CoolNamesAllTaken/vibamix/affinity/vibamix_placard/exports/vibamix_placard.pdf

# Vibamix

### A device for playing "will it blend" with people and personalities!

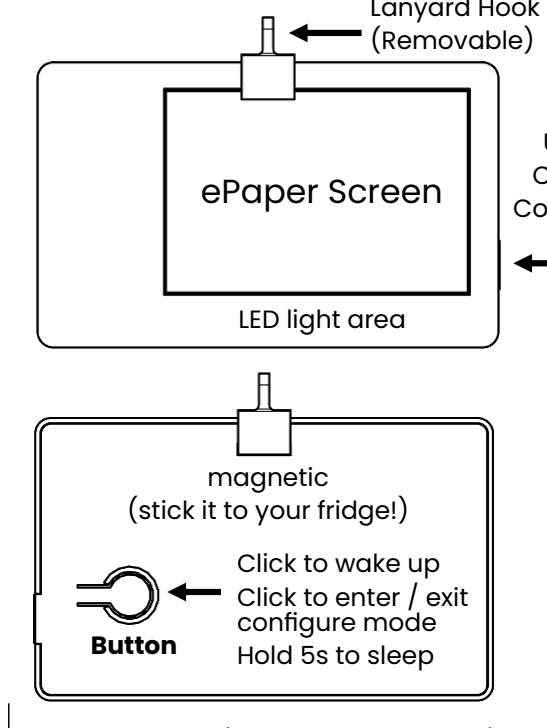
[picture p1: figure]
ePaper Screen; (Removable); LED light area; magnetic (stick it to your fridge!); Click to wake up Click to enter / exit configure mode Hold 5s to sleep Button

USB C
Charge

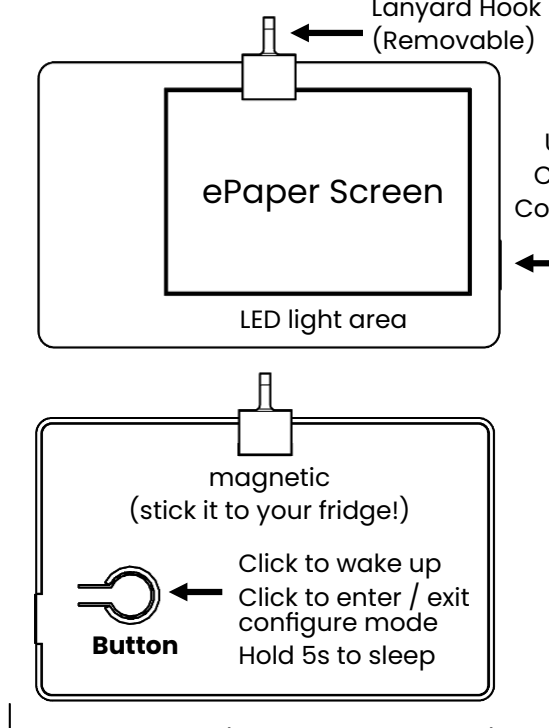
[picture p2: figure]
ePaper Screen; (Removable); LED light area; magnetic (stick it to your fridge!); Click to wake up Click to enter / exit configure mode Hold 5s to sleep Button

Connector

Lanyard Hook

github.com/CoolNamesAllTaken/vibamix

# Vibamix

### A device for playing "will it blend" with people and personalities!

USB C
Charge

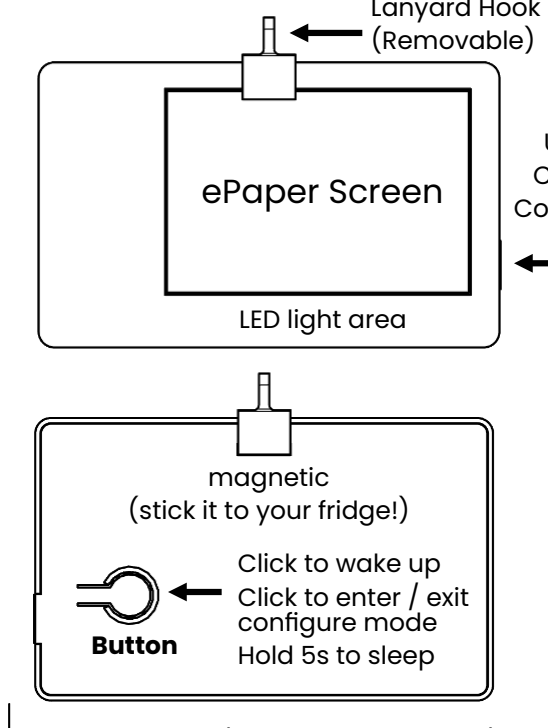
[picture p3: figure]
ePaper Screen; (Removable); LED light area; magnetic (stick it to your fridge!); Click to wake up Click to enter / exit configure mode Hold 5s to sleep Button

Connector

Lanyard Hook

github.com/CoolNamesAllTaken/vibamix

# Vibamix

### A device for playing "will it blend" with people and personalities!

USB C
Charge
Connector

Lanyard Hook

github.com/CoolNamesAllTaken/vibamix

# Vibamix

### A device for playing "will it blend" with people and personalities!

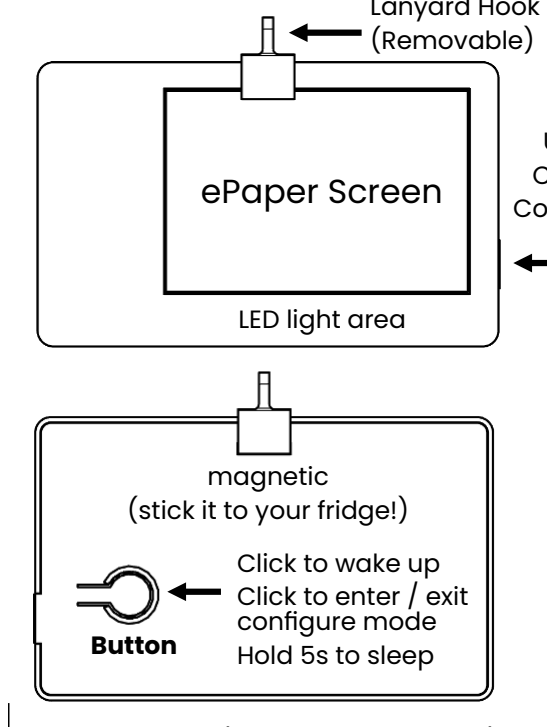
[picture p4: figure]
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

USB C
Charge

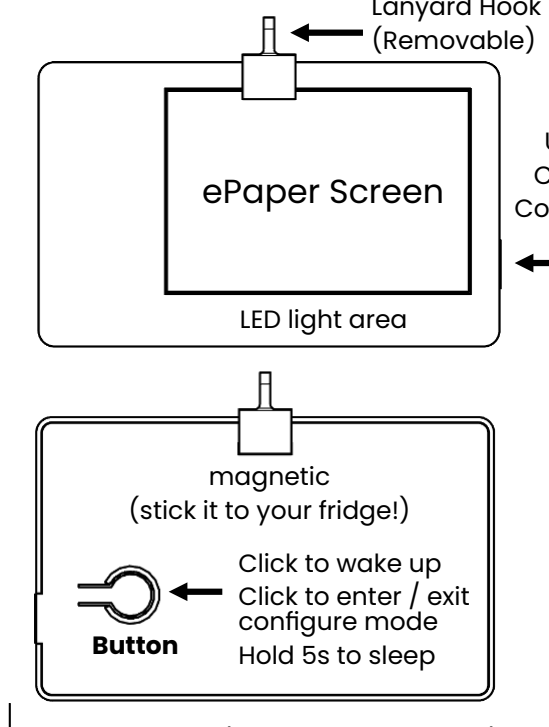
[picture p5: figure]
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

Connector

Lanyard Hook

github.com/CoolNamesAllTaken/vibamix

# Vibamix

### A device for playing "will it blend" with people and personalities!

USB C
Charge

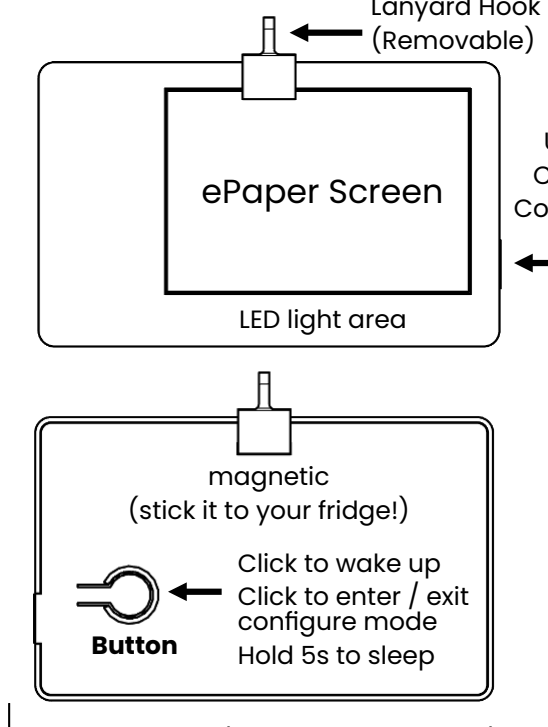
[picture p6: figure]
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

Connector

Lanyard Hook

github.com/CoolNamesAllTaken/vibamix

# Vibamix

### A device for playing "will it blend" with people and personalities!

USB C
Charge
Connector

Lanyard Hook

github.com/CoolNamesAllTaken/vibamix

# Vibamix

### A device for playing "will it blend" with people and personalities!

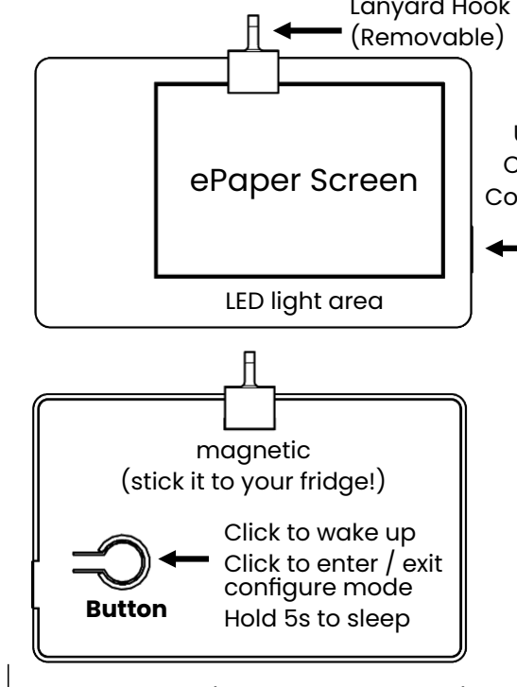
[picture p7: figure]
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

USB C
Charge

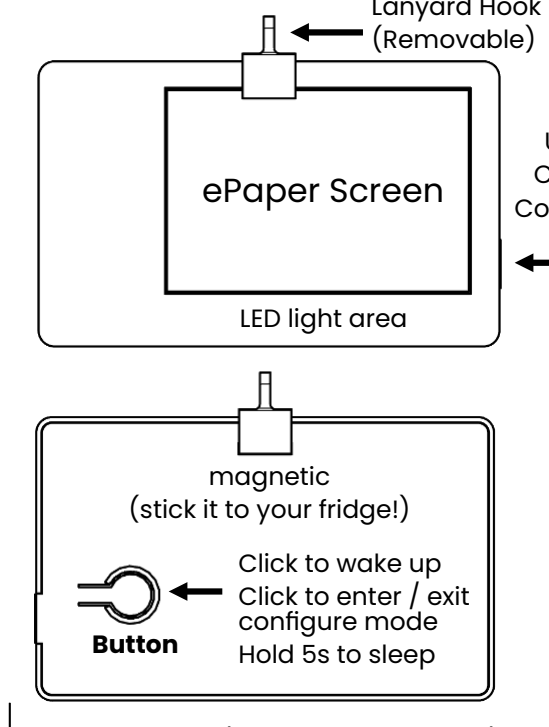
[picture p8: figure]
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

Connector

Lanyard Hook

github.com/CoolNamesAllTaken/vibamix

# Vibamix

### A device for playing "will it blend" with people and personalities!

USB C
Charge

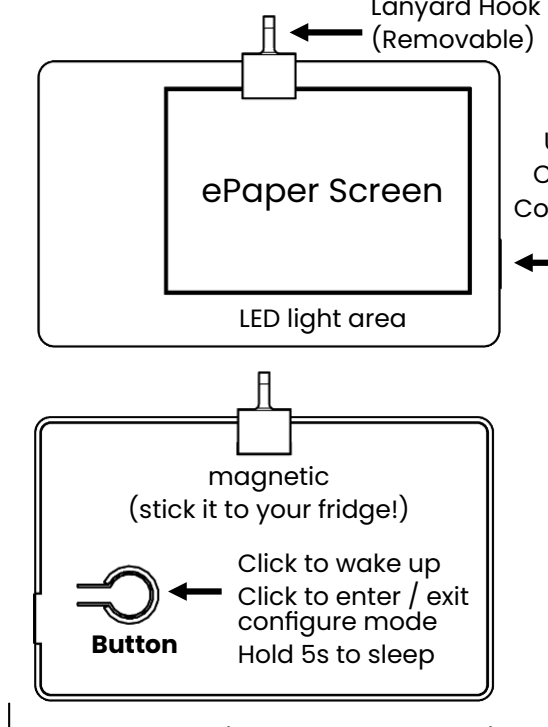
[picture p9: figure]
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

Connector

Lanyard Hook

github.com/CoolNamesAllTaken/vibamix

# Vibamix

### A device for playing "will it blend" with people and personalities!

USB C
Charge
Connector

Lanyard Hook

github.com/CoolNamesAllTaken/vibamix
