CoolNamesAllTaken/vibamix/affinity/vibamix_placard/exports/vibamix_placard_tiled.pdf

# Vibamix

### A device for playing "will it blend"

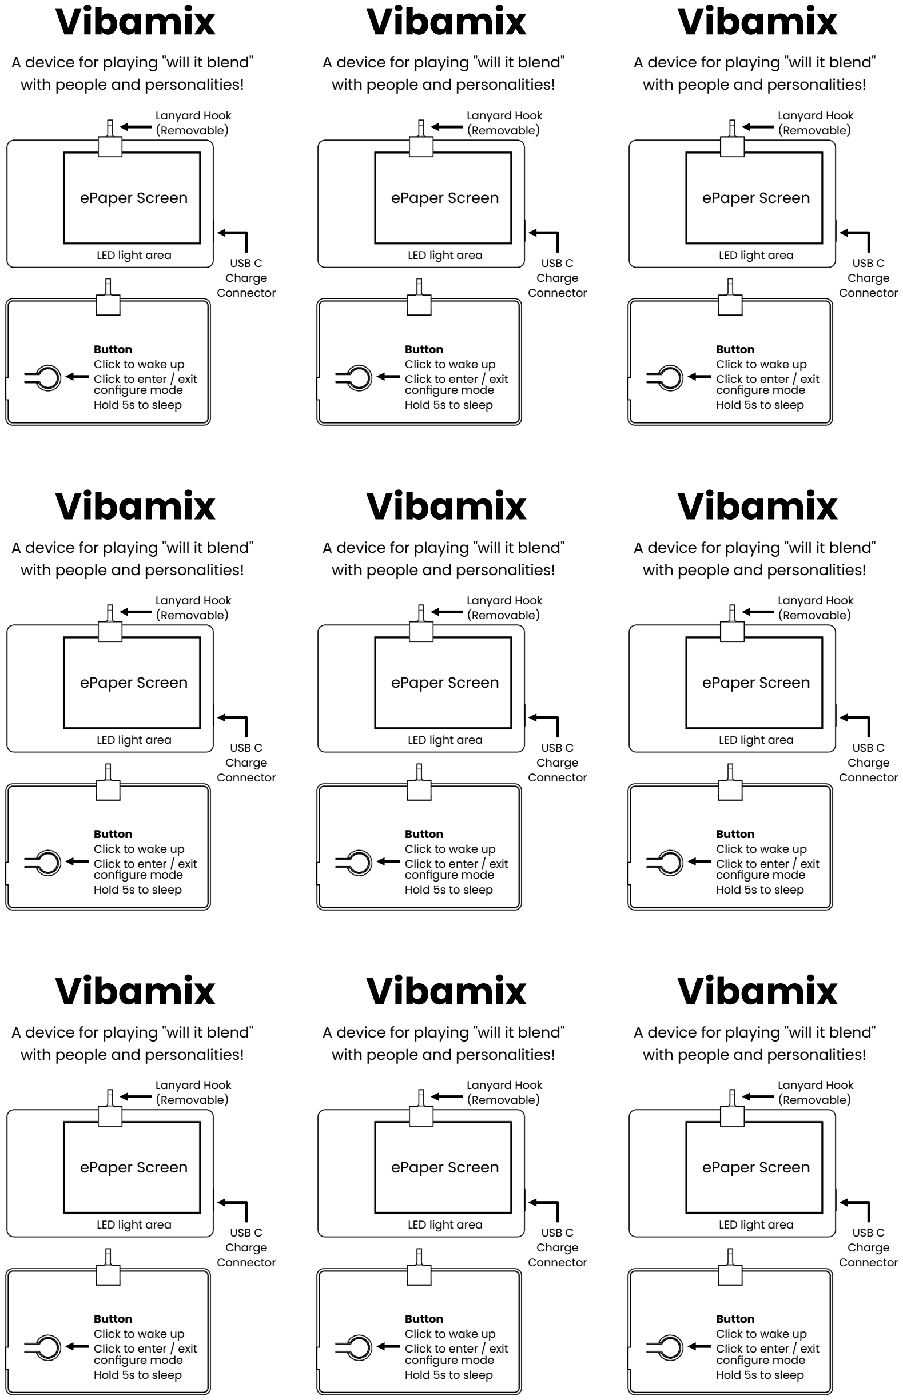
[picture p10: page 1]

### with people and personalities!

### ePaper Screen

USB C
Charge
Connector

Lanyard Hook
(Removable)

LED light area

Button
Click to wake up
Click to enter / exit
configure mode
Hold 5s to sleep

# Vibamix

### A device for playing "will it blend" with people and personalities!

### ePaper Screen

USB C
Charge
Connector

Lanyard Hook
(Removable)

LED light area

Button
Click to wake up
Click to enter / exit
configure mode
Hold 5s to sleep

# Vibamix

### A device for playing "will it blend" with people and personalities!

### ePaper Screen

USB C
Charge
Connector

Lanyard Hook
(Removable)

LED light area

Button
Click to wake up
Click to enter / exit
configure mode
Hold 5s to sleep

# Vibamix

### A device for playing "will it blend" with people and personalities!

### ePaper Screen

USB C
Charge
Connector

Lanyard Hook
(Removable)

LED light area

Button
Click to wake up
Click to enter / exit
configure mode
Hold 5s to sleep

# Vibamix

### A device for playing "will it blend" with people and personalities!

### ePaper Screen

USB C
Charge
Connector

Lanyard Hook
(Removable)

LED light area

Button
Click to wake up
Click to enter / exit
configure mode
Hold 5s to sleep

# Vibamix

### A device for playing "will it blend" with people and personalities!

### ePaper Screen

USB C
Charge
Connector

Lanyard Hook
(Removable)

LED light area

Button
Click to wake up
Click to enter / exit
configure mode
Hold 5s to sleep

# Vibamix

### A device for playing "will it blend" with people and personalities!

### ePaper Screen

USB C
Charge
Connector

Lanyard Hook
(Removable)

LED light area

Button
Click to wake up
Click to enter / exit
configure mode
Hold 5s to sleep

# Vibamix

### A device for playing "will it blend" with people and personalities!

### ePaper Screen

USB C
Charge
Connector

Lanyard Hook
(Removable)

LED light area

Button
Click to wake up
Click to enter / exit
configure mode
Hold 5s to sleep

# Vibamix

### A device for playing "will it blend" with people and personalities!

### ePaper Screen

USB C
Charge
Connector

Lanyard Hook
(Removable)

LED light area

Button
Click to wake up
Click to enter / exit
configure mode
Hold 5s to sleep
