CoolNamesAllTaken/vibamix/reference/PCA10156-nRF54L15-DK 1_0_0/Production files/BOM/PCA10156_BOM_Web.xls

Bill of material
Board: | PCA10156
Version: | 1.0.0
Designator | Value | Description | Assembly | Footprint Doc | Manufacturer | Manufacturer Part Number
C1, C2 | 2.2µF | Capacitor, Ceramic, 2.2µF 2.5V X6T 0201,±20% |  | 0201 | Murata | GRM033R61A225KE47
C3 | 10µF | Capacitor, X6S, ±20%, 6.3V |  | 0402 | N.A. | N.A.
C4, C7, C8, C10, C11, C13, C14, C15, C18, C20, C21, C22, C25, C29, C34, C35, C36, C37, C44, C46, C48, C49, C52, C53, C55, C56, C57, C62, C63, C64, C65, C66, C69, C70, C72, C73, C74, C75, C76, C77, C78, C79 | 100nF | Capacitor, X5R, ±10% |  | 0201 | N.A. | N.A.
C5, C33 | 2.2nF | Capacitor, X7R, ±10%, 10V |  | 0201 | N.A. | N.A.
C6 | 1.5pF | Capacitor, NP0, ±0.05pF, 25V, High Q |  | 0201 | Murata | GJM0335C1E1R5WB01
C9 | 2.0pF | Capacitor, NP0, ±0.05pF, 25V |  | 0201 | Murata | GJM0335C1E2R0WB01
C12, C30 | 10nF | Capacitor, X7R, ±10% |  | 0201 | N.A. | N.A.
C16, C28, C31, C32, C39, C45, C50, C51, C68 | 1.0µF | Capacitor, X5R, ±10%, 6.3V |  | 0402 | N.A. | N.A.
C17, C19 | 300pF | Capacitor, C0G, ±5%, 50V |  | 0402 | N.A. | N.A.
C23 | 2.2µF | Capacitor, X5R, ±10% |  | 0402 | N.A. | N.A.
C24, C26, C27 | 10µF | Capacitor, X7T, ±20%, 10V |  | 0603 | Murata | GRM188D71A106MA73
C38 | 1.4pF | Capacitor, C0G, ±0.05pF, 25V |  | 0201 | Murata | GJM0335C1E1R4WB01D
C40 | 2.2µF | Capacitor, X7R, ±10%, 6.3V |  | 0603 | N.A. | N.A.
C41 | 100nF | Capacitor, X7R, ±10% |  | 0402 | N.A. | N.A.
C42, C43, C54, C58 | 4.7µF | Capacitor, X7S, ±10%, 10V |  | 0603 | N.A. | N.A.
C47 | 1.0µF | Capacitor, Ceramic, X5R, ±10%, 16V |  | 0402 | Murata | GRT155R61C105KE01D
C59 | 10nF | Capacitor, X7R, ±10%, 100V |  | 0603 | Murata | GCM188R72A103KA37D
C60 | 3.9pF | Capacitor, NP0, ±0.05pF, 25V |  | 0201 | Murata | GJM0333C1E3R9WB01
C61 | 0.3pF | Capacitor, C0G, ±0.1pF, 50V |  | 0201 | Murata | GRM0335C1HR30BA01
C67 | 10nF | Capacitor, X7R, ±10% | Not Mounted | 0201 | N.A. | N.A.
FB1 | 120R/0.2A | Ferrite Bead, 120 Ohm @ 100MHz, 200mA, 500 mOhm Max |  | 0201 | Murata | BLM03AG121SN1D
FB2, FB3 | 120R/0.55A | Ferrite Bead, 120 Ohm @ 100MHz, 500mA, 250 mOhm Max |  | 0402 | Murata | BLM15AG121SN1D
Fid1, Fid2, Fid3 | N.A. | Fiducial Mark |  | Fiducial | N.A. | N.A.
J1 | MM8130-2600 | Coaxial Connector with Switch |  | COAXIAL-SWF | Murata | MM8130-2600
J3 | USB-C 2.0 | USB-C Receptacle, 16 Pin, USB 2.0 |  | SD-80259-001 | Bellweather Electronic Corp. | SD-80259-1021
J7 | FPC 0.5mm RA SMD | 0.5mm FPC, 5P,Right Angle SMT,Double Contact,H=1.2mm,White, Tin plated |  | FPC_05P-0.5mm-RA-SMD | WCON | 5141-05RZDNWR03
JP1 | Shunt 2.54mm | Shunt Jumper 2.54mm Black, open top | Place on P6 pin 2 and 3 | SHUNT JUMPER 2.54mm | WCON | 3710-6001OS0B05
L1 | 4.7µH | Inductor, 120mA, ±20%, 0.65R |  | 0603 | TDK Corporation | MLZ1608M4R7WT000
L2 | 2.7nH | Inductor, 600mA, ±0.1ｎH, 120mOhm |  | 0201 | Murata | LQP03HQ2N7B02
L3, L4 | 3.5nH | Inductor, 500mA, ±0.1ｎH, 170mOhm |  | 0201 | Murata | LQP03HQ3N5B02
L8 | 2.2µH | Inductor, Irms=2.5A, Isat=2.9A, ±20%, DCR=73mΩ |  | 0806 | Samsung Electro-Mechanics America | CIGT201610EH2R2MNE
LABEL1 | 12x12mm | PCA version label, stick-on, 12x12mm |  | Label | Ellco Etikett | A33512‐01
LD1, LD2, LD3, LD4, LD5 | L0603G | LED, Green, 0603, 573nm, Vf=2.0V, 24mcd, - 40 to +85°C |  | 0603 | Victory Electronics | VS 25C7M5
P0, P1, P2 | Pin Hdr 2x10 | Pin Header 2x10, 2.54mm (100mil) SMD |  | HDR_2x10-SMD-2.54MM | WCON | 1125-1210S0M116CR09
P3 | Pin List 1x2 | Pin List 1x2, 2.54mm (100mil) |  | LIST_1x2 | N.A. | N.A.
P4 | Pin List 1x3 | Pin List 1x3, 2.54mm (100mil) |  | LIST_1x3 | N.A. | N.A.
P5, P6 | Pin List 1x3 | Pin List 1x3, 2.54mm (100mil), SMD |  | LIST_1x3_SMD | WCON | 1125-1103S0M116CR04
P15, P19 | Pin Header 2x5, 1.27mm | Pin Header 2x5, 1.27mm (50mil), SMD, Keying Shroud |  | HDR_2x5-SMD-1.27mm | WCON | 3132-10MS0BK00R5
P16 | Pin Header 2x10, 1.27mm | Pin Header 2x10, 1.27mm (50mil), SMD, Keying Shroud |  | HDR_2x10-SMD-1.27mm | WCON | 3132-20MS0BK00R1
P30, P31, P32 | Pin Header 2x2 SMD | Pin Header 2x2, SMD, 2.54mm (100mil) |  | HDR_2x2-SMD | WCON | 1125-1202S0M116CR03
Q1, Q2, Q3 | NX138AKS | MOSFET 2N-CH 60V 0.17A TSSOP6 (SOT363) |  | TSSOP6 | Nexperia | NX138AKSX
Q4 | PBSS4330PA | 30V, 3A, 2.1W, G=270, NPN Transistor |  | HUSON-3 (2x2) | Nexperia | PBSS4330PA,115
R1, R2, R19, R20 | 680R | Resistor, ±1%, 0.05W |  | 0201 | N.A. | N.A.
R3, R9, R38 | 0R | Resistor, ±5%, 0.05W |  | 0201 | N.A. | N.A.
R4, R37, R41, R42 | 10k | Resistor, ±1%, 0.05W |  | 0201 | N.A. | N.A.
R5 | 560R | Resistor, ±1%, 0.05W |  | 0201 | N.A. | N.A.
R6, R8, R13, R14, R15, R16, R17, R23, R31, R32, R35, R39, R56 | 100k | Resistor, ±1%, 0.05W |  | 0201 | N.A. | N.A.
R7 | 47R | Resistor, ±1%, 0.05W |  | 0201 | N.A. | N.A.
R10, R11, R12, R18, R27 | 1M0 | Resistor, ±1%, 0.05W |  | 0201 | N.A. | N.A.
R21, R22, R25, R28, R29, R30, R33, R34 | 0R | Resistor, ±5%, 0.063W |  | 0402 | N.A. | N.A.
R24 | TBD | Chip Res 0402 |  | 0402 | N.A. | N.A.
R26 | 47k | Resistor, ±1%, 0.05W |  | 0201 | N.A. | N.A.
R36 | 1k | Resistor, ±1%, 0.05W |  | 0201 | N.A. | N.A.
R40 | 2R2 | Resistor, ±1%, 0.05W |  | 0201 | N.A. | N.A.
R43 | 33k | Resistor, ±1%, 0.05W |  | 0201 | N.A. | N.A.
SW1, SW2, SW3, SW5, SW6 | PB SW | Tactile Switch, SPNO, SMD, 160gf, 6.2x6.3x2.5mm |  | Switch-PB-6.2x6.3mm-SMD | Dailywell | TS604VM1-025BR-R
SW4 | Switch | SMD slide Switch (ON-ON) |  | Switch-Slide-RA-J-Lead-DPDT-8.5x3.5mm | C&K | JS202011JAQN
TP22 | TP | PC TEST POINT TIN SMD L |  | Harwin S1751-46R | Harwin | S1751-46R
U1 | nRF54L15-QFAA | Multi-protocol Bluetooth Low Energy, IEEE 802.15.4 and 2.4GHz proprietary Wireless MCU |  | QFN-48 | Nordic Semiconductor | nRF54L15-QFAAC00
U2 | nRF5340-QKAA | Multi-protocol Bluetooth Low Energy, IEEE 802.15.4, ANT and 2.4GHz proprietary system-on-chip |  | AQFN-98 | Nordic Semiconductor | nRF5340-QKAAD0
U3, U8 | TMUX1574 | Low-Capacitance, 2:1 (SPDT) 4-Channel, analog switch |  | UFQFN-16 | Texas Instruments | TMUX1574RSVR
U4, U5, U6 | TMUX1511 | Low-Capacitance, 1:1 (SPST) 4-Channel, analog switch |  | UFQFN-16 | Texas Instruments | TMUX1511RSVR
U7, U12, U13, U14 | TXB0104 | 4-Bit Bidirectional Level-Shifter/Voltage Translator with Automatic Direction Sensing |  | 12-UFQFN | Texas Instruments | TXB0104RUTR
U9 | MX25R6435F | Ultra low power, 64M-bit, serial multi I/O flash memory |  | WSON-8 | Macronix | MX25R6435FZNIL0
U10 | nPM1300-QEAAC0 | Li-Ion/Li-Polymer USB-C battery charger with high efficiency buck regulators, LDOs or load switches, LED drivers, TWI and VBUSOUT |  | QFN-32 | Nordic Semiconductor | nPM1300-QEAAC0
U11 | ECMF02-4CMX8 | 2 Line Common mode filter with ESD protection for USB 2.0 interface |  | UFDFN-8 | STMicroelectronics | ECMF02-4CMX8
U15 | TLV271 | Dual rail to rail CMOS Amplifier |  | SOT-25 | Diodes Incorporated | TLV271CW5-7
X1 | 32.768kHz | XTAL SMD 2012, 32.768kHz, 9pF, ±20ppm |  | XTAL_2012 | TXC Corporation | 9HT11-32.768KDZC-T
X2, X3 | 32MHz | XTAL SMD 2016, 32MHz, Cl=8pF, Tol: ±10ppm, Stab: ±15ppm |  | XTAL_2016 | Golledge | MP06003
