CoolNamesAllTaken/vibamix/3d/vibamix_xiao_enclosure.3mf

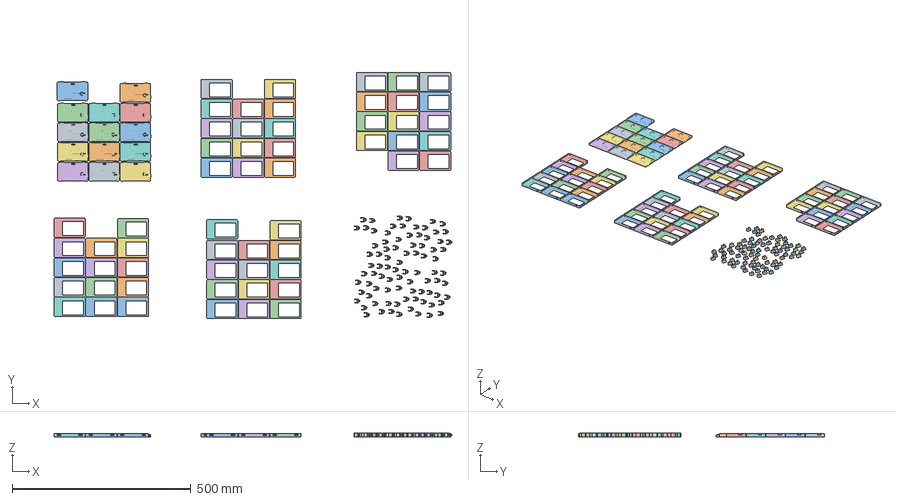
[picture p11: CAD file, 2026-06-20]
3d/vibamix_xiao_enclosure.3mf
1112.4 x 688.4 x 10.0 mm
Assembly x 14
Enclosure - Front Shell (2).step x 42
Enclosure (5).step x 14
Enclosure - Lanyard Clasp.step x 85
