CoolNamesAllTaken/vibamix/reference/PCA10156-nRF54L15-DK 1_0_0/Production files/ASSEMBLY/400708_Assembly_Drawing.pdf

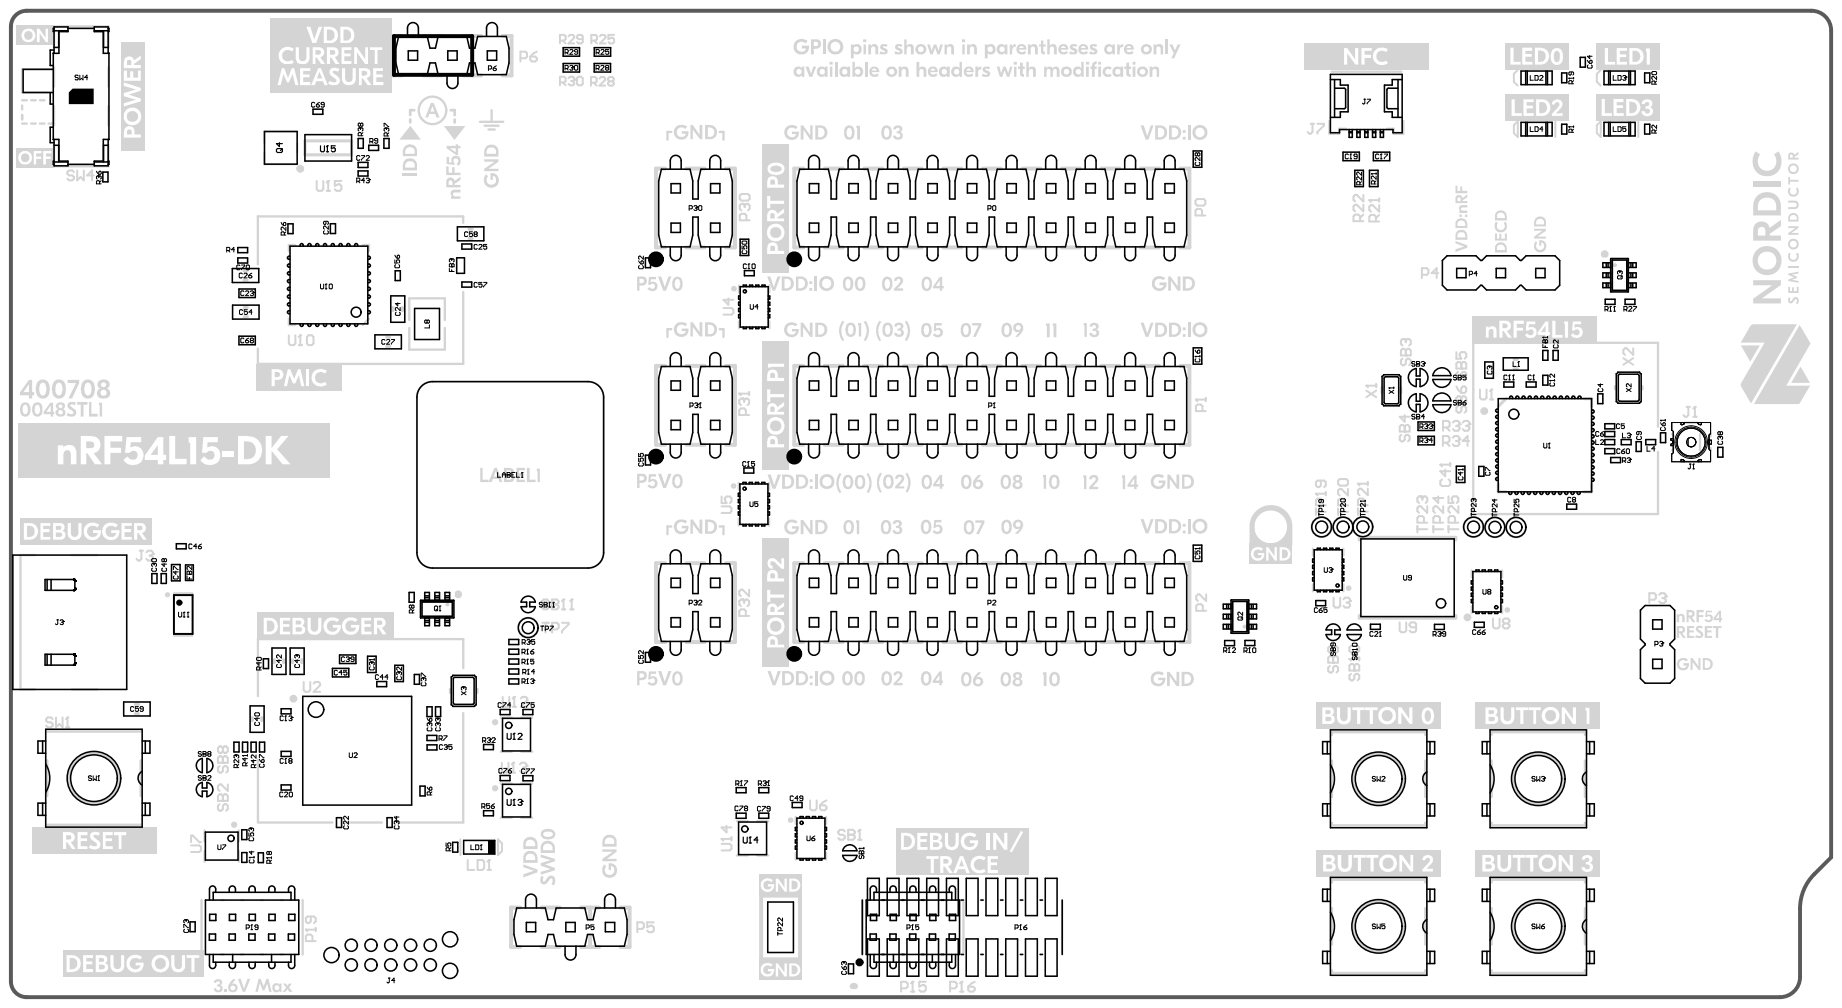
[picture p12: page 1]

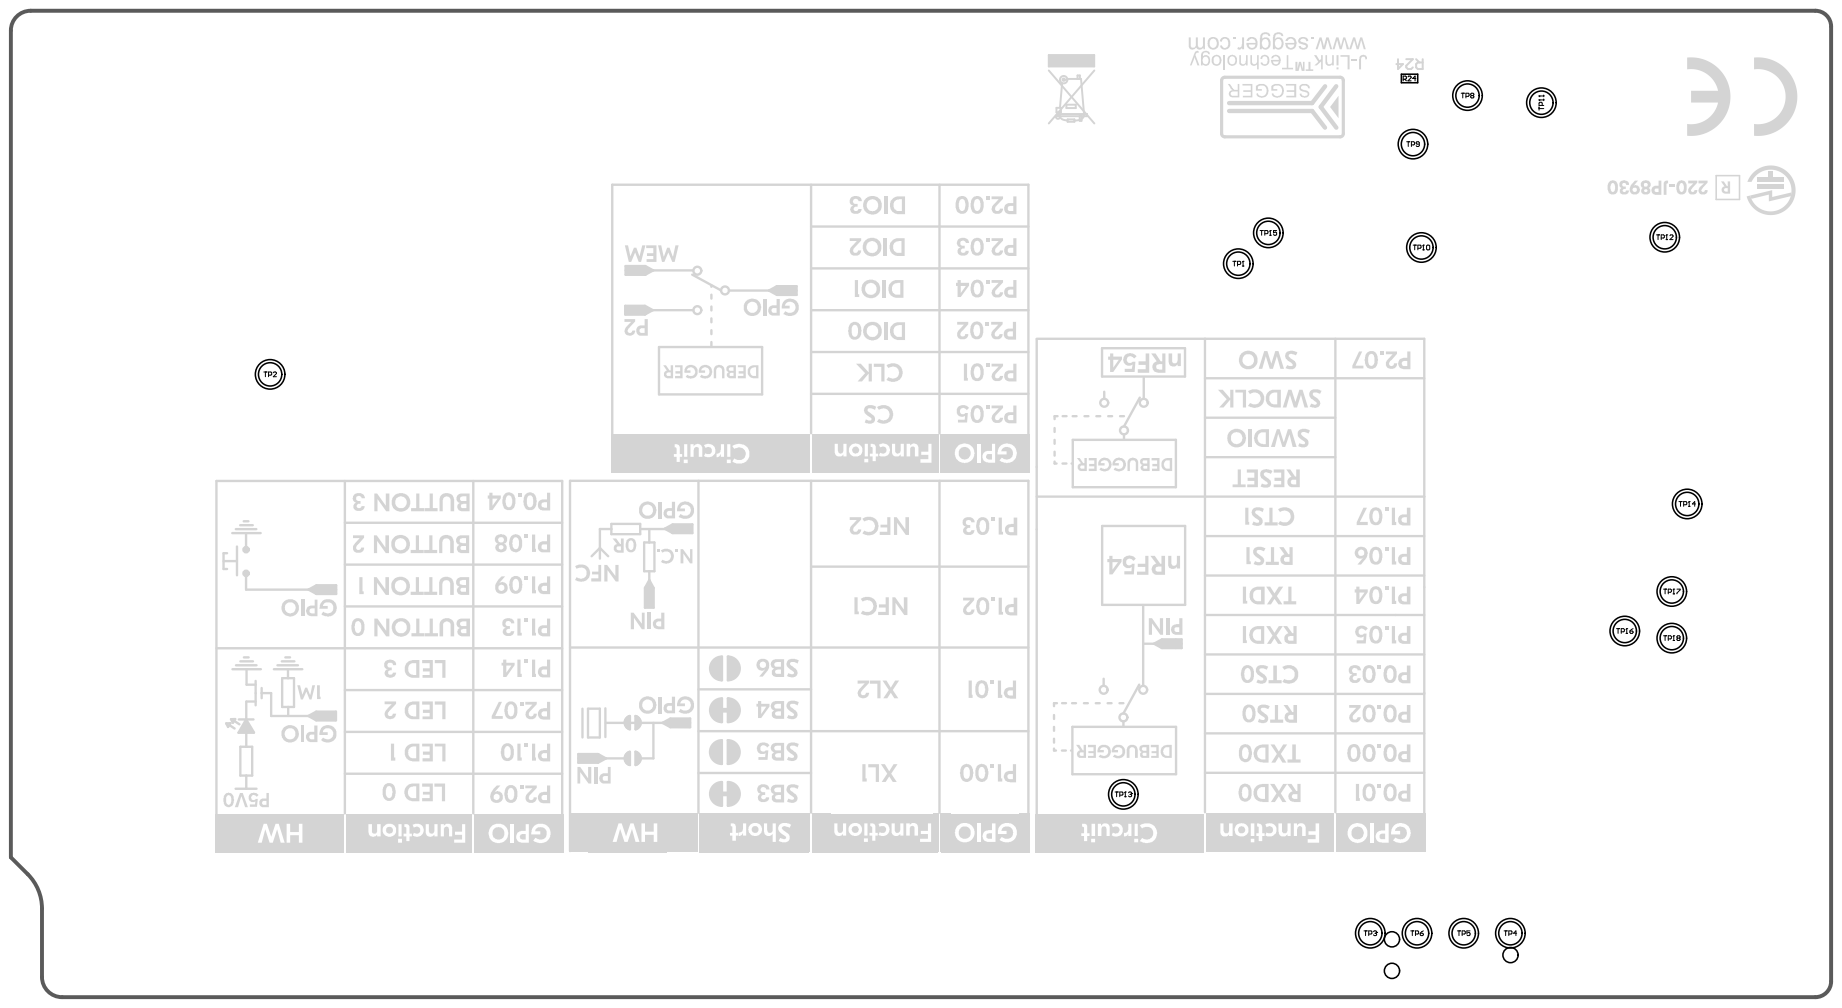
[picture p13: page 2]
