CoolNamesAllTaken/vibamix/(list of files, drawings)

Other design files:
reference/PCA10156-nRF54L15-DK 1_0_0/Altium Designer files/pca10156.PrjPCB
reference/PCA10156-nRF54L15-DK 1_0_0/Altium Designer files/pca10156_sheet1_connections.SchDoc
reference/PCA10156-nRF54L15-DK 1_0_0/Altium Designer files/pca10156_sheet2_nRF54L15.SchDoc
reference/PCA10156-nRF54L15-DK 1_0_0/Altium Designer files/pca10156_sheet3_debugger.SchDoc
reference/PCA10156-nRF54L15-DK 1_0_0/Altium Designer files/pca10156_sheet4_level_shifters.SchDoc
reference/PCA10156-nRF54L15-DK 1_0_0/Altium Designer files/pca10156_sheet5_misc.SchDoc
reference/PCA10156-nRF54L15-DK 1_0_0/Altium Designer files/pca10156_sheet6_power_supply.SchDoc
reference/PCA10156-nRF54L15-DK 1_0_0/Altium Designer files/pca10156_sheet7_connectors.SchDoc
reference/PCA10156-nRF54L15-DK 1_0_0/Altium Designer files/pca10156_sheet8_switches.SchDoc
