CoolNamesAllTaken/vibamix/kicad/vibamix_xiao/vibamix_xiao.kicad_pcb

## KiCad design kicad/vibamix_xiao/vibamix_xiao.kicad_pcb (2026-05-06)

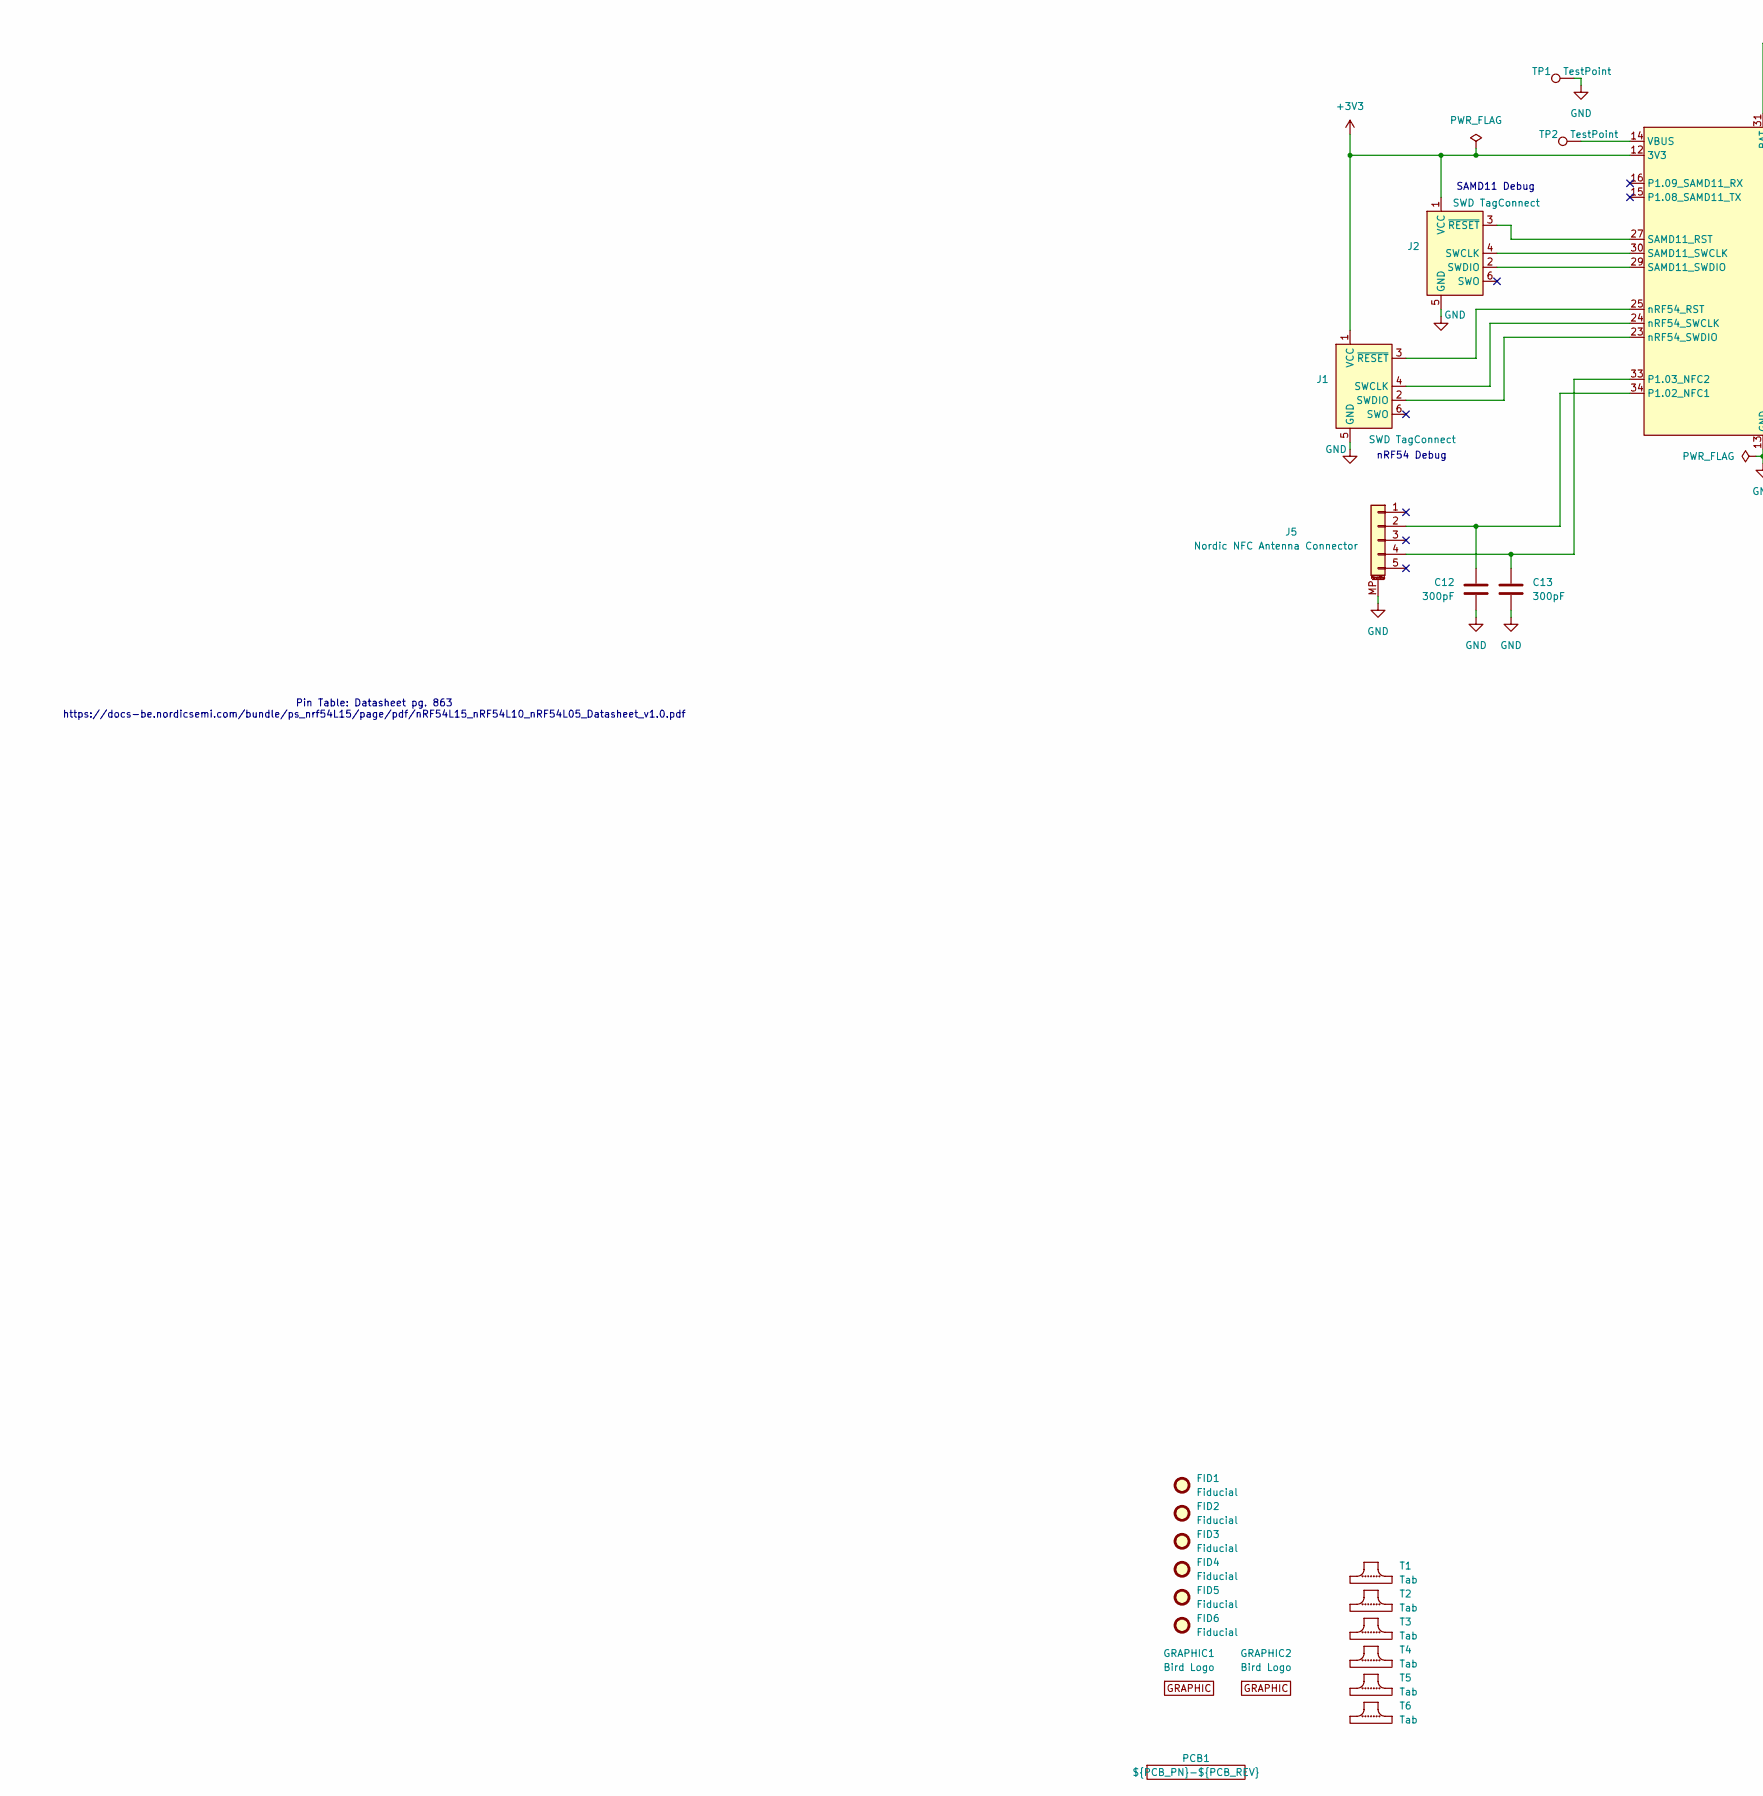
[picture p14: schematic vibamix_xiao.kicad_sch, ${PROJECT_NAME}, part in row 1, column 1]

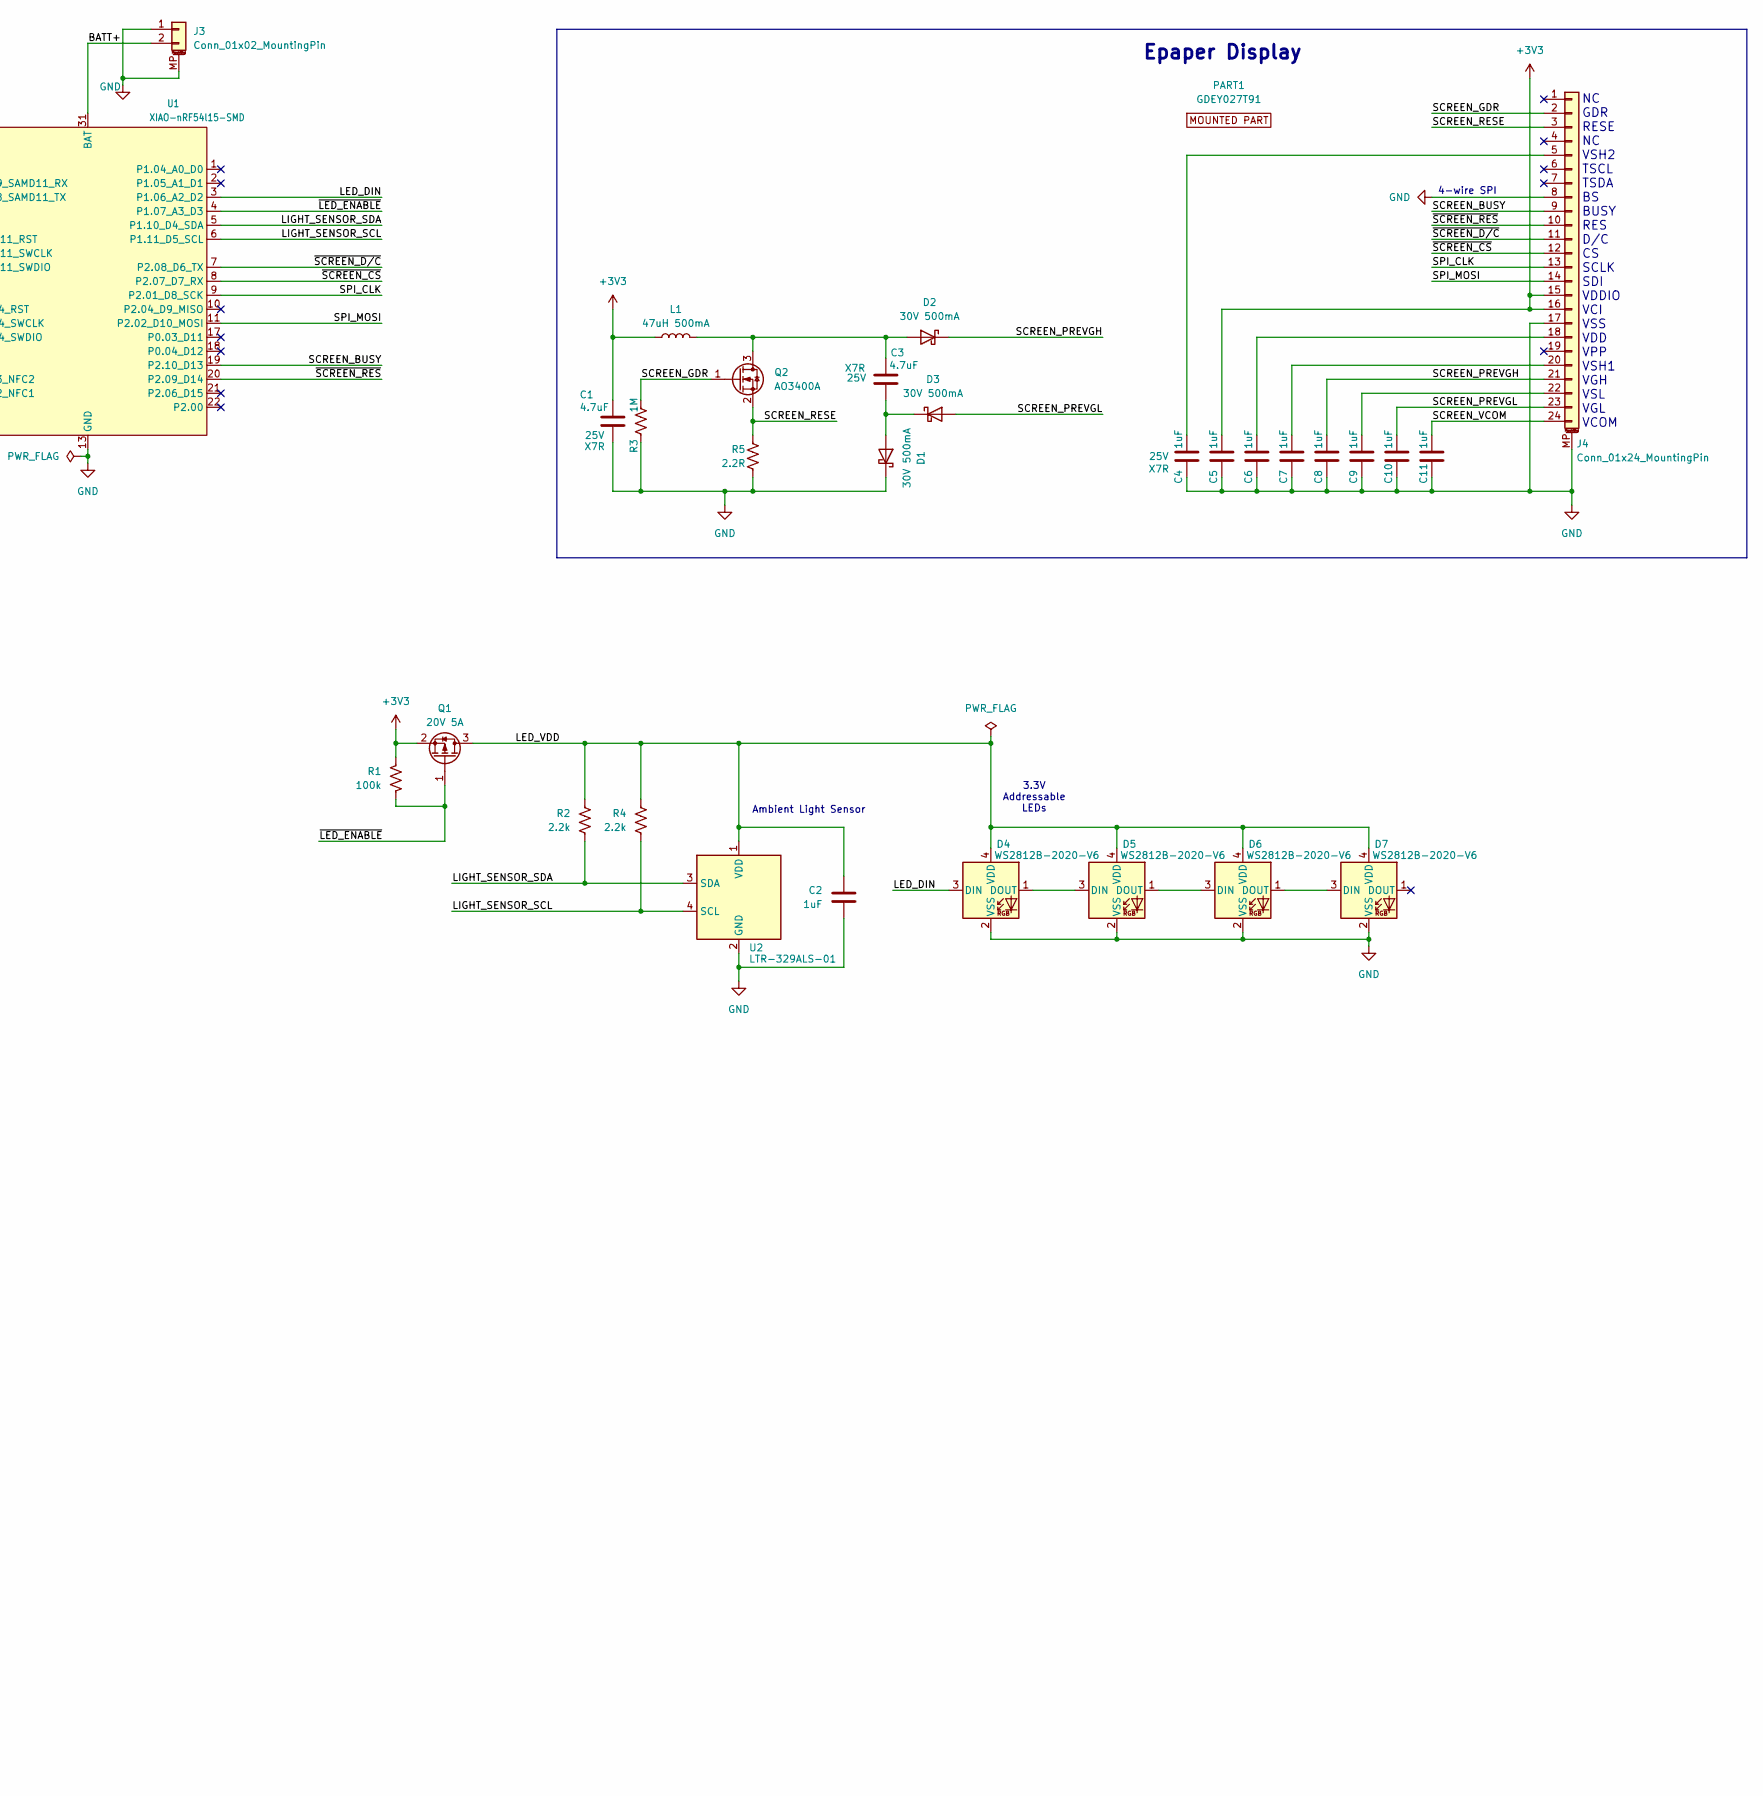
[picture p15: schematic vibamix_xiao.kicad_sch, ${PROJECT_NAME}, part in row 1, column 2]

Parts:
C1, C3: 4.7uF; C_0805_2012Metric; Voltage 25V; Tolerance 10%; MPN CL21B475KAFNNNE; LCSC PN C98195
C2, C4, C5, C6, C7, C8, C9, C10, C11: 1uF; C_0603_1608Metric; Voltage 25V; MPN CL10B105KA8NNNC; LCSC PN C29936
C12, C13: 300pF; C_0402_1005Metric; MPN GRM1555C1H301JA01D
D1, D2, D3: 30V 500mA; D_SOD-123; MPN B0530W-7-F; LCSC PN C124188
D4, D5, D6, D7: WS2812B-2020-V6; LED_WS2812B-2020_PLCC4_2.0x2.0mm; MPN WS2812B-2020-V6; LCSC PN C52917434
FID1, FID2, FID3, FID4, FID5, FID6: Fiducial; Fiducial_0.5mm_Mask1mm_NoCourtyard
GRAPHIC1: Bird Logo; BirdWithPants_Small_Left
GRAPHIC2: Bird Logo; BirdWithPants_Small_Right
J1, J2: SWD TagConnect; Tag-Connect_TC2030-IDC-NL_2x03_P1.27mm_Vertical
J3: Conn_01x02_MountingPin; Molex_PicoBlade_53261-0271_1x02-1MP_P1.25mm_Horizontal; MPN 0532610271
J4: Conn_01x24_MountingPin; Hirose_FH34SRJ-24S-0.5SH_1x24-1MP_P0.50mm_Horizontal_Mirror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; MPN FH34SRJ-24S-0.5SH(50)
J5: Nordic NFC Antenna Connector; FPC-SMD_5P-P0.50_HCTL_HC-FPC-05-10-5RLTAG; MPN HC-FPC-05-10-5RLTAG
L1: 47uH 500mA; L_APV_ANR4012; MPN ANR4012T470M; LCSC PN C7497063
PART1: GDEY027T91; GDEY027T91_NoSlot; MPN GDEY027T91
PCB1: ${PCB_PN}-${PCB_REV}; PCB_PN_REV_Tiny_Silkscreen; MPN ${PCB_PN}
Q1: 20V 5A; SOT-23; MPN DMG2305UX-7
Q2: AO3400A; SOT-23; MPN AO3400A
R1: 100k; R_0402_1005Metric; MPN RC0402FR-07100KL
R2, R4: 2.2k; R_0402_1005Metric; MPN RC0402FR-072K2L
R3: 1M; R_0402_1005Metric; Tolerance 1%; MPN RC0402FR-071ML; LCSC PN C138033
R5: 2.2R; R_0603_1608Metric; Tolerance 1%; MPN RC0603FR-072R2L; LCSC PN C112307
T1, T2, T3, T4, T5, T6: Tab
TP1, TP2: TestPoint; TestPoint_Pad_D1.0mm
U1: XIAO-nRF54l15-SMD; MPN XIAO-nRF54l15-SMD
U2: LTR-329ALS-01; Lite-On_LTR-329ALS-01; MPN LTR-329ALS-01

Connections:
+3V3: C1.2, C5.1, J1.1 (VCC), J2.1 (VCC), J4.15, J4.16, L1.1, Q1.2 (S), R1.1, U1.12 (3V3), U1.28 (3V3)
/BATT+: J3.2, U1.31 (BAT)
/LED_DIN: D4.3 (DIN), U1.3 (P1.06_A2_D2)
/LED_VDD: C2.1, D4.4 (VDD), D5.4 (VDD), D6.4 (VDD), D7.4 (VDD), Q1.3 (D), R2.1, R4.1, U2.1 (VDD)
/LIGHT_SENSOR_SCL: R4.2, U1.6 (P1.11_D5_SCL), U2.4 (SCL)
/LIGHT_SENSOR_SDA: R2.2, U1.5 (P1.10_D4_SDA), U2.3 (SDA)
/SCREEN_BUSY: J4.9, U1.19 (P2.10_D13)
/SCREEN_GDR: J4.2, Q2.1 (G), R3.2
/SCREEN_PREVGH: C8.1, D2.1 (K), J4.21
/SCREEN_PREVGL: C10.1, D3.2 (A), J4.23
/SCREEN_RESE: J4.3, Q2.2 (S), R5.1
/SCREEN_VCOM: C11.1, J4.24
/SPI_CLK: J4.13, U1.9 (P2.01_D8_SCK)
/SPI_MOSI: J4.14, U1.11 (P2.02_D10_MOSI)
/~LED_ENABLE: Q1.1 (G), R1.2, U1.4 (P1.07_A3_D3)
/~SCREEN_CS: J4.12, U1.8 (P2.07_D7_RX)
/~SCREEN_D/C: J4.11, U1.7 (P2.08_D6_TX)
/~SCREEN_RES: J4.10, U1.20 (P2.09_D14)
GND: C1.1, C2.2, C4.2, C5.2, C6.2, C7.2, C8.2, C9.2, C10.2, C11.2, C12.2, C13.2, D1.1 (K), D4.2 (VSS), D5.2 (VSS), D6.2 (VSS), D7.2 (VSS), J1.5 (GND), J2.5 (GND), J3.1, J3.MP (MountPin), J4.8, J4.17, J4.MP (MountPin), J5.MP (MountPin), R3.1, R5.2, TP1.1 (1_1), U1.13 (GND), U1.26 (GND), U1.32 (GND), U2.2 (GND)
unnamed: C3.1, D1.2 (A), D3.1 (K)
unnamed: C3.2, D2.2 (A), L1.2, Q2.3 (D)
unnamed: D4.1 (DOUT), D5.3 (DIN)
unnamed: D5.1 (DOUT), D6.3 (DIN)
unnamed: D6.1 (DOUT), D7.3 (DIN)
unnamed: J1.4 (SWCLK), U1.24 (nRF54_SWCLK)
unnamed: J1.2 (SWDIO), U1.23 (nRF54_SWDIO)
unnamed: J1.3 (~RESET), U1.25 (nRF54_RST)
unnamed: J2.4 (SWCLK), U1.30 (SAMD11_SWCLK)
unnamed: J2.2 (SWDIO), U1.29 (SAMD11_SWDIO)
unnamed: J2.3 (~RESET), U1.27 (SAMD11_RST)
unnamed: C4.1, J4.5
unnamed: C6.1, J4.18
unnamed: C7.1, J4.20
unnamed: C9.1, J4.22
unnamed: C12.1, J5.2, U1.34 (P1.02_NFC1)
unnamed: C13.1, J5.4, U1.33 (P1.03_NFC2)
unnamed: TP2.1 (1_1), U1.14 (VBUS)

Notes on the sheet:
SAMD11 Debug
Ambient Light Sensor
NC GDR RESE NC VSH2 TSCL TSDA BS BUSY RES D/C CS SCLK SDI VDDIO VCI VSS VDD VPP VSH1 VGH VSL VGL VCOM
Pin Table: Datasheet pg. 863 https://docs-be.nordicsemi.com/bundle/ps_nrf54L15/page/pdf/nRF54L15_nRF54L10_nRF54L05_Datasheet_v1.0.pdf
Epaper Display
4-wire SPI
nRF54 Debug
3.3V Addressable LEDs

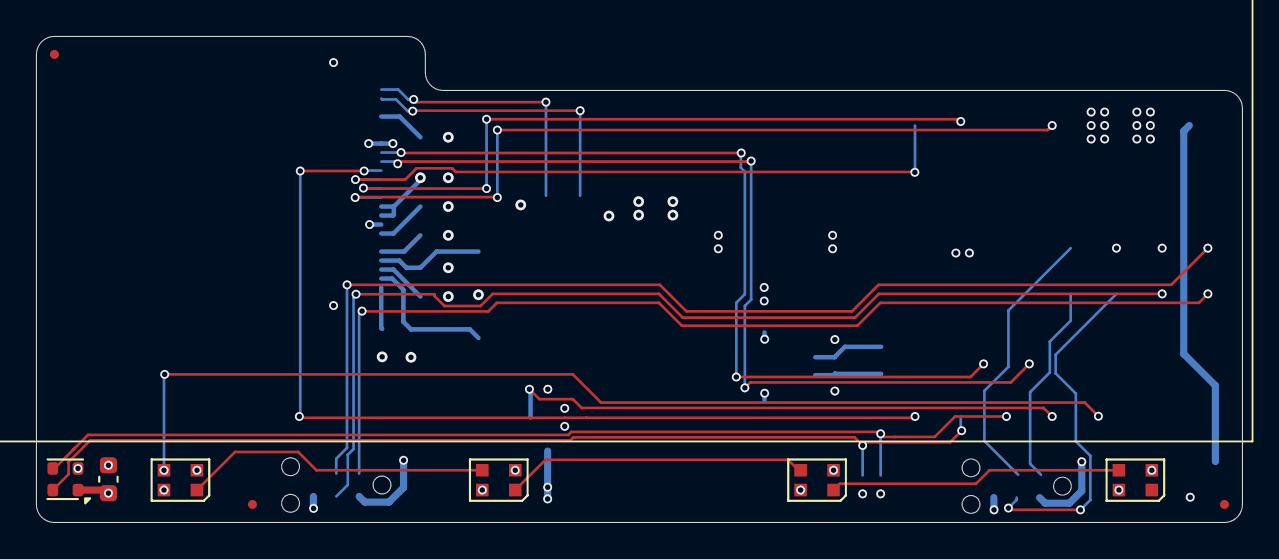
[picture p16: board vibamix_xiao.kicad_pcb from above]

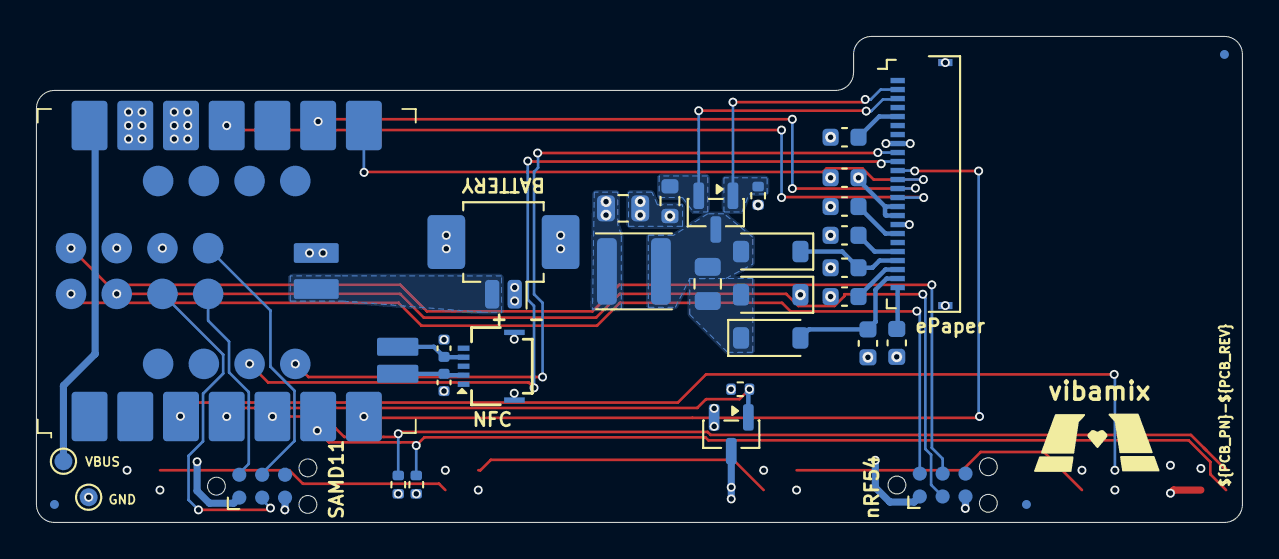
[picture p17: board vibamix_xiao.kicad_pcb from below]

Board: 4 copper layers, 67.0 x 27.0 mm, 53 parts (37 on the bottom side), 37 nets.
