CoolNamesAllTaken/vibamix/kicad/vibamix/vibamix.kicad_pcb

## KiCad design kicad/vibamix/vibamix.kicad_pcb (2026-05-04)

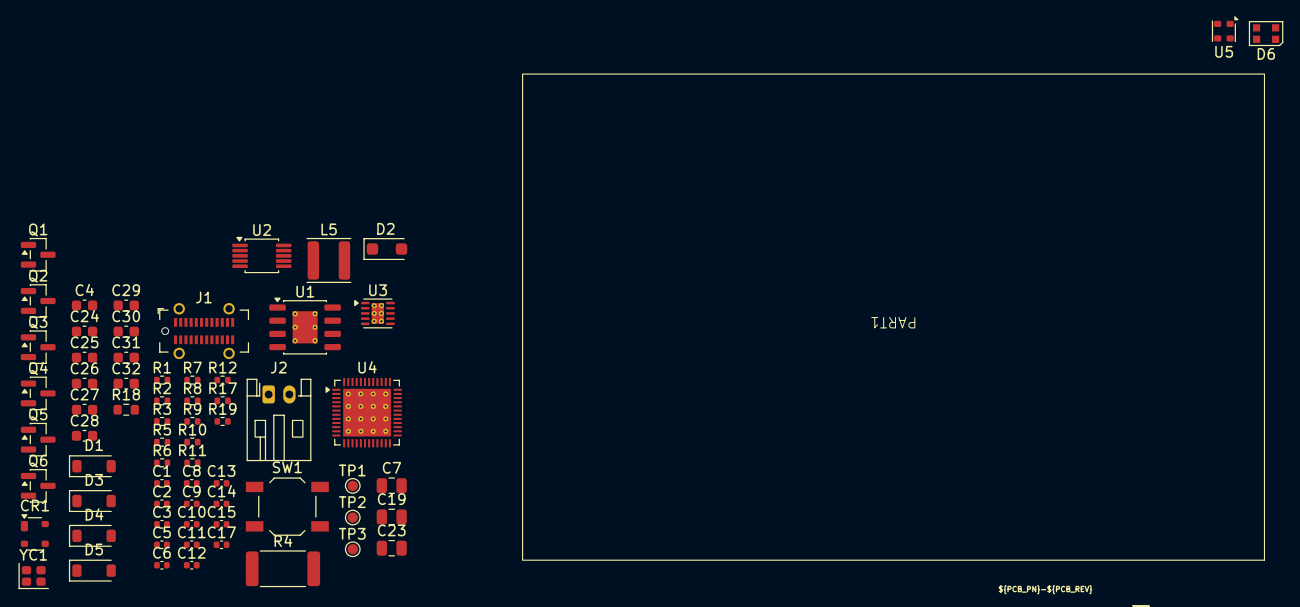
[picture p18: board vibamix.kicad_pcb from above]

Board: 4 copper layers, 78 parts (1 on the bottom side), 35 nets, no tracks yet.

Parts:
C1, C2, C5, C8, C9, C10, C11, C13: 10uF; C_0402_1005Metric
C3, C6, C12, C14, C15, C17: 0.1uF; C_0402_1005Metric
C4, C24, C25, C26, C27, C28, C29, C30, C31, C32: 1uF; C_0603_1608Metric
C7: 10uF; C_0805_2012Metric
C19, C23: 4.7uF; C_0805_2012Metric
CR1: DRTR5V0U2SR-7; SOT-143
D1: 1N4148; D_SOD-123
D2: 40V 2A; D_SOD-123F
D3, D4, D5: 30V 500mA; D_SOD-123
D6: WS2812B-2020-V6; LED_WS2812B-2020_PLCC4_2.0x2.0mm
GRAPHIC1: Bird Logo; BirdWithPants_Small_Left
H1, H2: M2.5 Mounting Hole; MountingHole_2.7mm_M2.5_Isolated
J1: USB_C_Receptacle_USB2.0; USB_C_Receptacle_GCT_USB4115-03-C
J2: JST-PH 01x02 Male; JST_PH_S2B-PH-K_1x02_P2.00mm_Horizontal
J4: Conn_01x24_MountingPin; Hirose_FH34SRJ-24S-0.5SH_1x24-1MP_P0.50mm_Horizontal_Mirror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
L5: 47uH 500mA; L_APV_ANR4012
PART1: GDEY027T91; GDEY027T91-FL02
PCB1: PCB_PN-A; PCB_PN_REV_Tiny_Silkscreen
Q1, Q3, Q5: AO3400A; SOT-23
Q2, Q4, Q6: 20V 4.2A; SOT-23
R1, R2, R6: 5.1k 1%; R_0402_1005Metric
R3, R5, R10: 10k; R_0402_1005Metric
R4: 0.47R 1% 1W; R_2512_6332Metric
R7, R8, R9, R11, R12, R19: 100k; R_0402_1005Metric
R17: 1M; R_0402_1005Metric
R18: 2.2R; R_0603_1608Metric
SW1: SW_Push; SW_SPST_TL3342
T1, T2, T3, T4: Tab
TP1, TP2, TP3: TestPoint; TestPoint_Pad_D1.0mm
U1: TP4056; HSOP-8-1EP_3.9x4.9mm_P1.27mm_EP2.41x3.1mm_ThermalVias
U2: CH340E; MSOP-10_3x3mm_P0.5mm
U3: TPS63900; WSON-10-1EP_2.5x2.5mm_P0.5mm_EP1.2x2mm_ThermalVias
U4: nRF54L15-QDXX; QFN-48-1EP_6x6mm_P0.4mm_EP4.6x4.6mm_ThermalVias
U5: LTR-329ALS-01; Lite-On_LTR-329ALS-01
YC1: 32MHz; Crystal_SMD_2016-4Pin_2.0x1.6mm

Connections:
+BATT: C5.1, J2.2, Q2.2 (S), R5.1, R7.1, U1.5 (BAT)
/DECA: U4.33 (DECRF), U4.43 (DECA)
/LED_ENABLE: Q6.1 (G), R19.2
/LED_VDD: C29.1, D6.4 (VDD), Q6.3 (D), U5.1 (VDD)
/POHO_CTRL: Q1.1 (G), R3.1
/POHO_OUT: C7.1, Q2.3 (D), Q4.3 (D), R9.1
/REG_IN: C8.1, D2.1 (K), Q4.2 (S), U3.1 (EN), U3.10 (VIN)
/SCREEN_GDR: J4.2, Q5.1 (G), R17.2
/SCREEN_PREVGH: C28.1, D4.1 (K), J4.21, TP1.1 (1_1)
/SCREEN_PREVGL: C31.1, D5.2 (A), J4.23, TP2.1 (1_1)
/SCREEN_RESE: J4.3, Q5.2 (S), R18.1
/SCREEN_VCOM: C32.1, J4.24, TP3.1 (1_1)
/VDD_VOLTAGE_SELECT: R11.2, R12.1, U3.2 (SEL)
GND: C1.2, C2.2, C3.1, C5.2, C6.1, C8.2, C9.2, C10.2, C11.2, C12.1, C13.2, C14.1, C15.1, C17.1, C19.1, C24.2, C25.2, C26.2, C27.2, C28.2, C29.2, C30.2, C31.2, C32.2, CR1.1 (GND), D3.1 (K), D6.2 (VSS), J1.A1 (GND), J1.A12 (GND), J1.B1 (GND), J1.B12 (GND), J2.1, J4.8, J4.17, J4.MP (MountPin), Q1.2 (S), Q3.2 (S), R1.2, R2.2, R3.2, R6.2, R10.2, R12.2, R17.1, R18.2, SW1.1, U1.3 (GND), U1.9 (GND), U2.3 (GND), U3.8 (GND), U3.11 (GND), U4.32 (VSS_PA), U4.44 (VSS), U4.49 (VSS), U5.2 (GND), YC1.2 (G), YC1.4 (G)
unnamed: CR1.2 (IO1), J1.A6 (D+), J1.B6 (D+), U2.1 (UD+)
unnamed: CR1.3 (IO2), J1.A7 (D-), J1.B7 (D-), U2.2 (UD-)
unnamed: D1.2 (A), R8.2, R9.2
unnamed: C4.1, D1.1 (K), Q1.3 (D), R5.2, SW1.2
unnamed: C23.1, D3.2 (A), D5.1 (K)
unnamed: C23.2, D4.2 (A), L5.2, Q5.3 (D)
unnamed: J1.A5 (CC1), R1.1
unnamed: J1.B5 (CC2), R2.1
unnamed: C24.1, J4.5
unnamed: C26.1, J4.18
unnamed: C27.1, J4.20
unnamed: C30.1, J4.22
unnamed: C4.2, Q2.1 (G), Q3.3 (D), R7.2
unnamed: C7.2, Q3.1 (G), R8.1
unnamed: C1.1, R4.2, U1.4 (Vcc), U1.8 (CE)
unnamed: R6.1, U1.2 (PROG)
unnamed: C6.2, U2.10 (V3)
unnamed: U4.34 (XC1), YC1.1
unnamed: U4.35 (XC2), YC1.3
VBUS: C2.1, C3.2, CR1.4 (Vcc), D2.2 (A), J1.A4 (VBUS), J1.A9 (VBUS), J1.B4 (VBUS), J1.B9 (VBUS), Q4.1 (G), R4.1, R10.1, U2.7 (VCC)
VDD: C9.1, C10.1, C11.1, C12.2, C13.1, C14.2, C15.2, C17.2, C19.2, C25.1, J4.15, J4.16, L5.1, Q6.2 (S), R11.1, R19.1, U3.6 (VOUT), U4.10 (VDD), U4.22 (VDD), U4.36 (VDD), U4.47 (VDD), U4.48 (VDD)
