CoolNamesAllTaken/vibamix/firmware/vibamix_zephyr/boards/pants_for_birds/vibamix_xiao/vibamix_xiao_nrf54l15_cpuapp.dts

/dts-v1/;

#include <nordic/nrf54l15_cpuapp.dtsi>
#include "vibamix_xiao-pinctrl.dtsi"
#include <zephyr/dt-bindings/led/led.h>
#include <zephyr/dt-bindings/adc/adc.h>
#include <zephyr/dt-bindings/adc/nrf-saadc.h>

/ {
	model = "Xiao NRF54L15 ePaper badge.";
	compatible = "pants_for_birds,vibamix-xiao-cpuapp";

	chosen {
		/* Default app build links into slot A. The slot-B build overrides this
		 * via boards/.../slotb.overlay (direct-XIP A/B). */
		zephyr,code-partition = &slot_a_partition;
		zephyr,sram = &cpuapp_sram;
		zephyr,flash = &cpuapp_rram;
		zephyr,flash-controller = &rram_controller;
		zephyr,console = &uart22;
		zephyr,settings-partition = &storage_partition;
	};

	/* LED strip power enable - active low */
	leds {
		compatible = "gpio-leds";
		led_enable: led_enable {
			gpios = <&gpio1 7 GPIO_ACTIVE_LOW>;    /* P1.07 LED_ENABLE */
		};
		user_led: user_led {
			gpios = <&gpio2 0 GPIO_ACTIVE_LOW>;    /* P2.00 USER_LED  */
		};
		/* TPS22916 load switch enabling the battery-voltage divider.
		 * Drive active only while sampling the battery (it powers the 10K/10K
		 * divider on the AIN7 net) — see src/battery.c. */
		vbat_enable: vbat_enable {
			gpios = <&gpio1 15 GPIO_ACTIVE_HIGH>;  /* P1.15 VBAT_EN */
		};
		/* Antenna RF switch (U10, FM8625H). VDD must be powered for the switch
		 * to pass signal; VCTL selects the port:
		 *   RF_SW_CTL LOW  -> RF1 -> ANT1 (onboard chip antenna)
		 *   RF_SW_CTL HIGH -> RF2 -> ANT2 (external antenna)
		 * Driven active at boot in main() to select the external antenna. */
		rf_sw_pwr: rf_sw_pwr {
			gpios = <&gpio2 3 GPIO_ACTIVE_HIGH>;   /* P2.03 RF_SW_PWR */
		};
		rf_sw_ctl: rf_sw_ctl {
			gpios = <&gpio2 5 GPIO_ACTIVE_HIGH>;   /* P2.05 RF_SW_CTL */
		};
	};

	/* Battery voltage monitor: VBAT -> load switch -> 10K/10K divider -> P1.14 (AIN7).
	 * battery_mV = AIN7_mV * 2. */
	zephyr,user {
		io-channels = <&adc 0>;
	};

	buttons {
		compatible = "gpio-keys";
		user_button: user_button {
			/* External pullup — no GPIO_PULL_UP flag */
			gpios = <&gpio0 0 GPIO_ACTIVE_LOW>;    /* P0.00 USER_KEY  */
		};
	};

	aliases {
		led-strip   = &led_strip;
		epaper      = &epaper;
		user-led    = &user_led;
		user-button = &user_button;
		watchdog0   = &wdt31;
	};
};

/* Watchdog for the custom OTA rollback: the bootloader arms it before jumping;
 * the app feeds it and (PAUSE_IN_SLEEP) it stops during System OFF. See src/ota.c. */
&wdt31 {
	status = "okay";
};

/* Battery-voltage ADC on AIN7 (P1.14). The nRF54L15 SAADC internal reference is
 * 0.9 V and (unlike the nRF52) has no 1/6 gain, so use gain 1/4 -> 0..3.6 V full
 * scale, covering the ~1.5..2.1 V divider output for a 1S LiPo (3.0..4.2 V).
 * (ADC_GAIN_1_6 + 600 mV here silently failed adc_channel_setup -> "--V".) */
&adc {
	#address-cells = <1>;
	#size-cells = <0>;
	status = "okay";

	channel@0 {
		reg = <0>;
		zephyr,gain = "ADC_GAIN_1_4";
		zephyr,reference = "ADC_REF_INTERNAL";
		zephyr,vref-mv = <900>;
		zephyr,acquisition-time = <ADC_ACQ_TIME_DEFAULT>;
		zephyr,input-positive = <NRF_SAADC_AIN7>;   /* P1.14 divider midpoint */
		zephyr,resolution = <12>;
	};
};

/* Logging UART */
&uart22 {
	compatible = "nordic,nrf-uarte";
	status = "okay";
	pinctrl-0 = <&uart22_default>;
	pinctrl-1 = <&uart22_sleep>;
	pinctrl-names = "default", "sleep";
	current-speed = <115200>;
};

/* ePaper display on SPI00 (high-speed SERIAL00).
 * NOT on spi20: spi20 and i2c20 are the same SERIAL20 hardware block and are
 * mutually exclusive, so the display would clash with the light sensor on i2c20.
 * spi00 is the free high-speed SPIM and reaches the same P2.01/P2.02 pins, so the
 * ePaper lives here and the sensor keeps SERIAL20 — both run concurrently.
 */
&spi00 {
	compatible = "nordic,nrf-spim";
	status = "okay";
	pinctrl-0 = <&spi00_default>;
	pinctrl-1 = <&spi00_sleep>;
	pinctrl-names = "default", "sleep";
	cs-gpios = <&gpio2 7 GPIO_ACTIVE_LOW>;        /* P2.07 SCREEN_CS  */

	epaper: epaper@0 {
		compatible = "pants-for-birds,epaper";
		reg = <0>;
		spi-max-frequency = <4000000>;
		width = <176>;
		height = <264>;
		dc-gpios = <&gpio2 8 GPIO_ACTIVE_LOW>;    /* P2.08 SCREEN_D/C  */
		reset-gpios = <&gpio2 9 GPIO_ACTIVE_LOW>;    /* P2.09 SCREEN_RES  */
		busy-gpios = <&gpio2 10 GPIO_ACTIVE_HIGH>;    /* P2.10 SCREEN_BUSY */
	};
};

/* WS2812 LED strip on SPI21 - only MOSI (P1.06) is physically connected */
&spi21 {
	compatible = "nordic,nrf-spim";
	status = "okay";
	pinctrl-0 = <&spi21_default>;
	pinctrl-1 = <&spi21_sleep>;
	pinctrl-names = "default", "sleep";

	led_strip: ws2812@0 {
		compatible = "worldsemi,ws2812-spi";
		reg = <0>;
		/* 4 MHz: one SPI bit = 250 ns, so the frame patterns below give a
		 * 750 ns "1" pulse (T1H) and 250 ns "0" pulse (T0H). The 0x70/0x40
		 * pair is ONLY valid at 4 MHz — at 8 MHz the "1" pulse halves to
		 * 375 ns and every WS2812 bit decodes as 0 (all LEDs stay dark).
		 */
		spi-max-frequency = <DT_FREQ_M(4)>;
		chain-length = <4>;            /* D4-D7 WS2812B chain */
		color-mapping = <LED_COLOR_ID_GREEN
		LED_COLOR_ID_RED
		LED_COLOR_ID_BLUE>;
		spi-one-frame = <0x70>;        /* 0b01110000: 750 ns high @ 4 MHz */
		spi-zero-frame = <0x40>;       /* 0b01000000: 250 ns high @ 4 MHz */
	};
};

/* Light sensor I2C bus (SERIAL20). Free to use now that the ePaper moved off
 * spi20 to the high-speed spi00 — see the ePaper node above.
 */
&i2c20 {
	compatible = "nordic,nrf-twim";
	status = "okay";
	pinctrl-0 = <&i2c20_default>;
	pinctrl-1 = <&i2c20_sleep>;
	pinctrl-names = "default", "sleep";

	als: ltr329als@29 {
		compatible = "pants-for-birds,ltr329als";
		reg = <0x29>;
		status = "okay";
	};
};

&lfxo {
	load-capacitors = "internal";
	load-capacitance-femtofarad = <15000>;
};

&hfxo {
	load-capacitors = "internal";
	load-capacitance-femtofarad = <15000>;
};

&clock {
	status = "okay";
};

&radio {
	status = "okay";
};

&ieee802154 {
	status = "okay";
};

&temp {
	status = "okay";
};

&gpio0 {
	status = "okay";
};

&gpio1 {
	status = "okay";
};

&gpio2 {
	status = "okay";
};

&gpiote20 {
	status = "okay";
};

&gpiote30 {
	status = "okay";
};

&grtc {
	owned-channels = <0 1 2 3 4 5 6 7 8 9 10 11>;
	/* Channels 7-11 reserved for Zero Latency IRQs, 3-4 for FLPR */
	child-owned-channels = <3 4 7 8 9 10 11>;
	status = "okay";
};

&cpuapp_sram {
	status = "okay";
};

&cpuapp_rram {
	partitions {
		compatible = "fixed-partitions";
		#address-cells = <1>;
		#size-cells = <1>;

		/* Custom direct-XIP A/B layout (no MCUboot). The first-stage bootloader
		 * lives at 0x0 and CRC-verifies + chain-loads slot_a or slot_b; the app
		 * is built twice, linked per slot. See firmware/bootloader/ + src/ota.c. */
		bootloader_partition: partition@0 {
			label = "bootloader";
			reg = <0x0 DT_SIZE_K(48)>;
		};

		/* Bootloader metadata (per-slot valid/confirmed/version/attempts), written
		 * as a 32-byte append log; 2x 4K sectors for wear. See common/bl_state.c. */
		bl_state_partition: partition@c000 {
			label = "bl_state";
			reg = <0xc000 DT_SIZE_K(8)>;
		};

		slot_a_partition: partition@e000 {
			label = "image-a";
			reg = <0xe000 DT_SIZE_K(512)>;
		};

		slot_b_partition: partition@8e000 {
			label = "image-b";
			reg = <0x8e000 DT_SIZE_K(512)>;
		};

		/* Five 16K image slots (raw flash via flash_area; see src/badge_store.c):
		 * four user image frames (slots 0..3) plus the identity image (slot 4).
		 * Each slot holds a 2-bit grayscale (11616 B) or 1-bit B/W (5808 B) image
		 * plus a 16-byte header. */
		images_partition: partition@10e000 {
			label = "images";
			reg = <0x10e000 DT_SIZE_K(80)>;
		};

		storage_partition: partition@122000 {
			label = "storage";
			reg = <0x122000 DT_SIZE_K(264)>;
		};

		/* Per-unit factory record (assigned + written once at manufacturing by
		 * firmware/flashtool/; read-only at runtime via src/factory_id.c). Holds
		 * the badge's unique 15-bit id so the mesh unicast address / config code /
		 * GAP name don't collide across a large fleet. Kept at the flash tail so
		 * `storage` keeps its offset. */
		factory_partition: partition@164000 {
			label = "factory";
			reg = <0x164000 DT_SIZE_K(4)>;
		};
	};
};
