CoolNamesAllTaken/vibamix/firmware/vibamix_zephyr/src/MeshNode.h

#ifndef VIBAMIX_MESH_NODE_H
#define VIBAMIX_MESH_NODE_H

#include "GUI.h"
#include "LEDStrip.h"

/*
 * Bluetooth Mesh node for a vibamix badge. Replaces the old plain-BLE BLERadio.
 *
 * init() brings up Bluetooth + the mesh stack, loads persisted settings,
 * deterministically self-provisions the badge (baked keys, unicast address
 * derived from the FICR device id), binds the app key, subscribes the
 * "all badges" group, and enables the GATT proxy so a phone can connect to the
 * nearest badge and inject messages that flood across the mesh.
 *
 * Incoming vendor-model commands are dispatched (via file-scope C trampolines)
 * to the GUI and LED strip, and persisted through app_config.
 */
class MeshNode {
public:
    int init(GUI *gui, LEDStrip *leds);

    // Apply whatever config was restored from settings to the display + LEDs.
    void apply_persisted_config();

    // Stop the radio for deep sleep: park the mesh network (stops scan/relay/beacon
    // TX) then disable the BT controller so MPSL releases the radio + clocks and the
    // SoC can actually reach System OFF. The real System OFF path reboots on wake
    // (re-init via init()); only the debugger fake-sleep path needs radio_resume().
    void radio_suspend();
    // Undo radio_suspend(): re-enable BT and resume mesh activity.
    void radio_resume();

    // The LED strip this node drives (config mode borrows it to light per-frame
    // LEDs while a content frame is on the panel).
    LEDStrip *leds() const { return m_leds; }

    // Redraw the clean identity frame (name/ID + optional image), full refresh.
    // Used to rest the bistable panel on a bar-free frame before sleep. When
    // `sleeping` is set, a small "asleep" indicator (moon + z z z) is composited
    // into the corner before the refresh.
    void redraw_identity(bool sleeping = false);

    // True if the frame currently on the panel (identity, text, or image — whatever
    // was rendered last) is a full-screen 4-gray image. The awake-window countdown
    // uses this to decide whether it can tick a 1-bit overlay bar over the frame (it
    // can't over a 4-gray base — that would re-drive every mid-gray pixel); a 4-gray
    // frame instead holds static and auto-sleeps purely on the deadline/heartbeat.
    // Set by every render path (redraw_identity / do_show_text / do_image /
    // do_display_screen) so the bar adapts when content takes over mid-window.
    bool current_frame_is_gray() const { return m_current_gray; }

    // True if the frame currently on the panel is the identity frame (vs a text or
    // image frame). The awake-window countdown draws the name/ID banner only on the
    // identity frame; other frames get the bare countdown fill. Set by every render
    // path alongside m_current_gray.
    bool current_frame_is_identity() const { return m_current_is_identity; }

    // Called by file-scope C trampolines; not for external use.
    //
    // Mesh (broadcast, ephemeral): override the live LEDs / draw a text frame
    // straight to the panel — neither is stored.
    void on_show_led(uint8_t anim, uint8_t r, uint8_t g, uint8_t b);
    void on_show_text(const char *title, size_t tlen, const char *body, size_t blen);
    // Override LED brightness for the current LED state (cleared by the next state change).
    void on_set_brightness(uint8_t level);
    // Release a brightness override (resume ALS auto-adjust) without changing the LED state.
    void on_release_brightness();
    // Enter (on=1) / exit (on=0) config mode. Best-effort, awake badges only.
    void on_set_config_mode(uint8_t on);

    // Config-mode gateway: re-originate a vendor-model access payload (sent by a
    // GATT-connected app) onto the mesh "all badges" group.
    void on_mesh_tx(const uint8_t *access, size_t len);

    // GATT (individual, persistent) config — reused by the config-mode GATT path.
    void on_set_name(const char *name, size_t len);
    // image_xfer completion: store to `slot` (0xFF = render-only) + render.
    void on_image(uint8_t slot, uint8_t fmt, const uint8_t *buf, size_t len,
                  uint16_t w, uint16_t h);
    // Store a text screen (header + body) at `idx`.
    void on_set_screen(uint8_t idx, const char *hdr, size_t hlen,
                       const char *body, size_t blen);
    // Render a stored frame: kind text(0) / image(1) / identity(2).
    void on_display_screen(uint8_t kind, uint8_t idx);
    // Set the attendee/table ID (shown on the identity frame).
    void on_set_attendee_id(const char *id, size_t len);
    // Set a frame's LED animation + color; applies live if it's the shown frame.
    void on_set_frame_led(uint8_t kind, uint8_t idx, uint8_t anim,
                          uint8_t r, uint8_t g, uint8_t b);

    // Deferred rendering for the cold-boot awake window ("mesh mode"). While on, the
    // content handlers above (show_text / image / display_screen) only stage work on
    // the BT RX thread instead of driving the ePaper there — which would race the
    // main thread's countdown refresh and wedge the panel (killing the button).
    // run_awake_window() calls consume_pending_render() each iteration to render the
    // staged work on the main thread. Turning deferral off also drops staged work.
    void set_defer_renders(bool on);
    // Render any staged content on the calling (main) thread. Returns true if it
    // rendered something (caller re-bases its partial-refresh overlay).
    bool consume_pending_render();

private:
    void apply_frame_led(uint8_t kind, uint8_t idx);

    // Actual ePaper work for the content handlers, split out so it can run either
    // inline (deferral off) or from consume_pending_render() on the main thread.
    void do_show_text(const char *title, const char *body);
    void do_image(uint8_t slot, uint8_t fmt, const uint8_t *buf, size_t len,
                  uint16_t w, uint16_t h);
    void do_display_screen(uint8_t kind, uint8_t idx);

    GUI      *m_gui{nullptr};
    LEDStrip *m_leds{nullptr};
    bool      m_current_gray{false};
    bool      m_current_is_identity{true};
};

#endif /* VIBAMIX_MESH_NODE_H */
