CoolNamesAllTaken/vibamix/(commit log)

2026-05-06 PCBA Rev A
    [PCA10156_BOM_Web.xls, impedance_control.xlsx, vibamix_xiao.kicad_pcb, vibamix_xiao.kicad_sch]
2026-05-13 Add NRF application with ePaper driver migrated to Zephyr
2026-06-12 Adds Python App for Flashing Multiple Devices (#1)
    * Save progress
    * Save progress
    * Initial Commit
    * update gitignore
    * Update README.md
    * add build and flash to app
    ---------
2026-06-16 John/bringup (#3)
    * Add agents file
    * Commit enclosure stuff
    * Add uncommitted changes
    * Sync vibamix firmware with main
    * Remove baremetal vibamix directory
    * Add LED animation, swith to BLE mesh, update debug config
    * Get LEDs working
    * Add variable width font system and improve screen behavior
    [vibamix_xiao_enclosure.3mf]
2026-06-17 Fix contrast dying on partial refresh
    [Display_EPD_W21.cpp]
2026-06-18 Improve LED animations and fix display shift
    [ConfigMode.cpp, Display_EPD_W21.cpp, LEDStrip.cpp, LEDStrip.h, main.cpp]
2026-06-18 Maybe fix some OTA stuff
    [MeshNode.cpp, main.c]
2026-06-19 Fix ESD diode leakage current
    [LTR329ALS.cpp, LTR329ALS.h, ambient_light_sensor.cpp, ambient_light_sensor.h]
2026-06-19 5mA sleep
    [vibamix_xiao_enclosure.3mf]
2026-06-20 Change auto brightness adjustment thresholds on LEDs
2026-06-20 Make config screen the default, add OTA loading bar to ePaper, add brightness control mesh command, add rainbow sparkle LED animation, make badgectl adaptive height, add party mode button to badgectl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
    [ConfigMode.cpp, ConfigMode.h, LEDStrip.cpp, LEDStrip.h, MeshNode.cpp, MeshNode.h, config_gatt.c, config_gatt.h]
2026-06-20 Prune stale devices, update placard design
